supermileage/PROTO_PCB/PROTO_PCB-15_05_2023.png

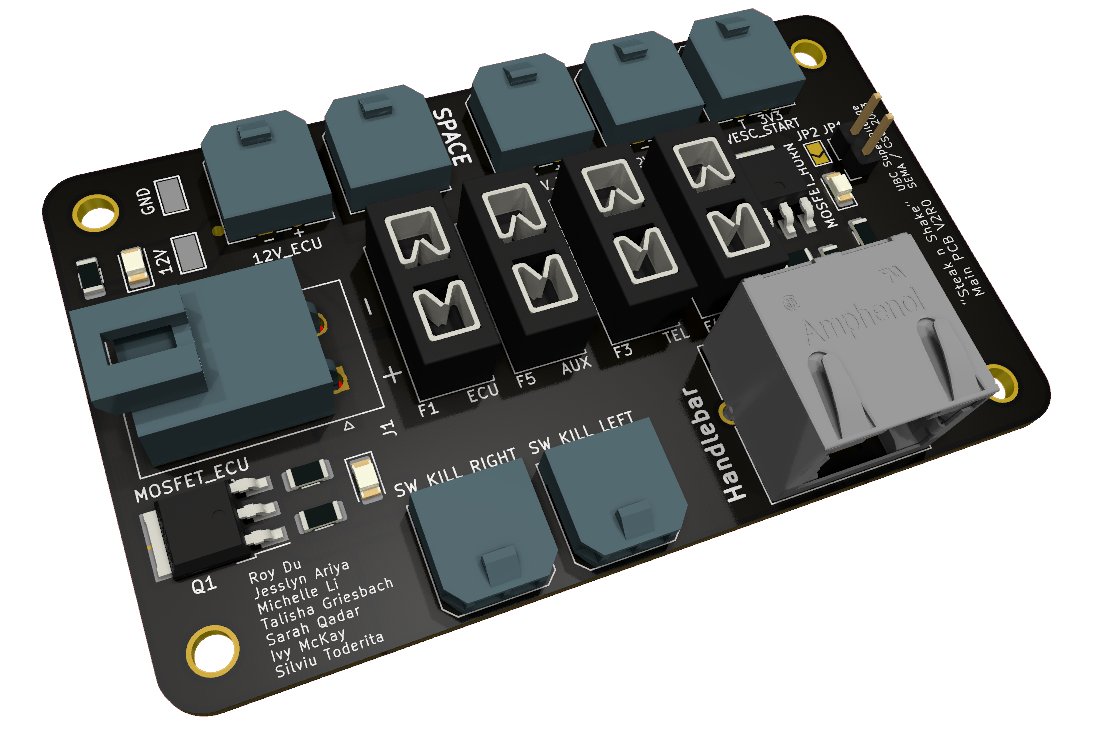
PROTO_PCB-15_05_2023.png
