supermileage/PROTO_PCB/BOM.xlsx

Designator | Qty | Manufacturer | Mfg Part # | Description / Value | DigiKey URL
F1,F2,F3,F4,F5 | 5 | Keystone Electronics | 3568 | FUSE HOLDER BLADE 500V 30A PCB | https://www.digikey.ca/en/products/detail/keystone-electronics/3568/2137306
J1 | 1 | Molex | 2002411212 | Connector Header Through Hole, Right Angle 2 position 0.224" (5.70mm) | https://www.digikey.ca/en/products/detail/molex/2002411212/10709048?s=N4IgTCBcDa4AxzAFgIwrOkBdAvkA
J2,J3,J4,J5,J6,J7,J8,J9,J10,J11,J12 | 11 | Molex | 0436500200 | Connector Header Through Hole, Right Angle 2 position 0.118" (3.00mm) | https://www.digikey.ca/en/products/detail/molex/0436500200/268989
L1,L3,L4 | 3 | Lite-On Inc. | LTST-C230KGKT | LED GREEN CLEAR CHIP SMD | https://www.digikey.ca/en/products/detail/lite-on-inc/LTST-C230KGKT/386855
L2 | 1 | Lite-On Inc. | LTST-C230KRKT | LED RED CLEAR CHIP SMD | https://www.digikey.ca/en/products/detail/lite-on-inc/LTST-C230KRKT/386857
Q1,Q2 | 2 | Infineon Technologies | IRFR120ZTRPBF | MOSFET N-CH 100V 8.7A DPAK | https://www.digikey.ca/en/products/detail/infineon-technologies/IRFR120ZTRPBF/1928290
R1,R2,R4 | 3 | Stackpole Electronics Inc | RMCF1206FT1K00 | RES 1K OHM 1% 1/4W 1206 | https://www.digikey.ca/en/products/detail/stackpole-electronics-inc/RMCF1206FT1K00/1759616
R3,R5 | 2 | Stackpole Electronics Inc | RMCF1206FT10K0 | RES 10K OHM 1% 1/4W 1206 | https://www.digikey.ca/en/products/detail/stackpole-electronics-inc/RMCF1206FT10K0/1759669
R6 | 1 | Stackpole Electronics Inc | RMCF1206FT100R | RES 100 OHM 1% 1/4W 1206 | https://www.digikey.ca/en/products/detail/stackpole-electronics-inc/RMCF1206FT100R/1759677
Not on PCB:
 | 1 | Molex | 2004561212 | MEGA-FIT RECEP HSG SR TOPL 2CKT | https://www.digikey.ca/en/products/detail/molex/2004561212/10709200
 | 2 | Molex | 0768230344 | MEGA-FIT FEMALE TML PRE-TIN 14/1 | https://www.digikey.ca/en/products/detail/molex/0768230344/10482725
 | 11 | Molex | 0436450200 | CONN RECEPT 2POS 3MM SINGLE ROW | https://www.digikey.ca/en/products/detail/molex/0436450200/268974
 | 22 | Molex | 0430300001 | CONN SOCKET 20-24AWG CRIMP TIN | https://www.digikey.ca/en/products/detail/molex/0430300001/467796
 | 4 |  |  | M3 x 6mm Screws
 | 4 | Littelfuse Inc. | 0297002.L | FUSE AUTO 2A 32VDC BLADE MINI | https://www.digikey.ca/en/products/detail/littelfuse-inc/0297002-L/3305643
 | 1 | Littelfuse Inc. | 0297005.WXNV | FUSE AUTO 5A 32VDC BLADE MINI | https://www.digikey.ca/en/products/detail/littelfuse-inc/0297005-WXNV/146583
