supermileage/PROTO_PCB/PROTO_PCB.kicad_pcb

## KiCad design PROTO_PCB.kicad_pcb (2023-05-17)

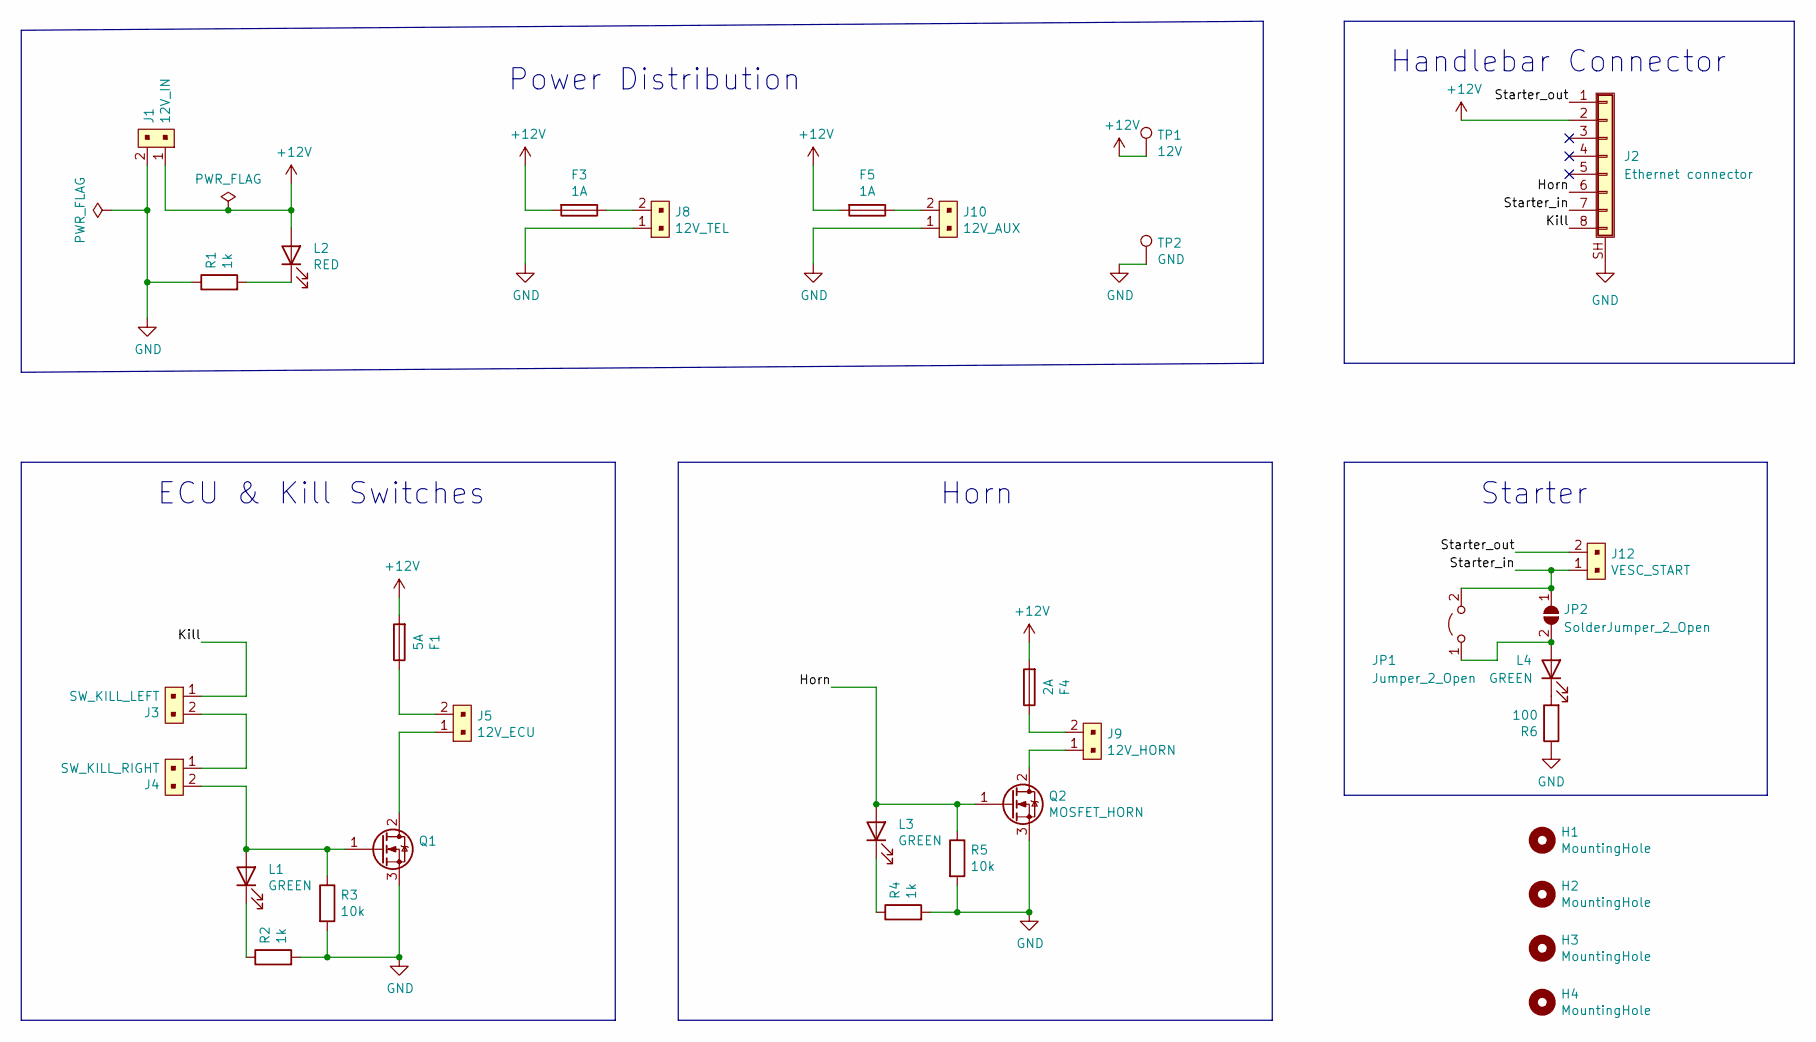
[picture p2: schematic PROTO_PCB.kicad_sch]

Parts:
F1: 5A; Fuseholder_Blade_Mini_Keystone_3568
F3, F5: 1A; Fuseholder_Blade_Mini_Keystone_3568
F4: 2A; Fuseholder_Blade_Mini_Keystone_3568
H1, H2, H3, H4: MountingHole; MountingHole_3.2mm_M3
J1: 12V_IN; MOLEX_2002411212
J2: Ethernet connector; RJ45_Amphenol_RJHSE5380
J3: SW_KILL_LEFT; Molex_Micro-Fit_3.0_43650-0200_1x02_P3.00mm_Horizontal
J4: SW_KILL_RIGHT; Molex_Micro-Fit_3.0_43650-0200_1x02_P3.00mm_Horizontal
J5: 12V_ECU; Molex_Micro-Fit_3.0_43650-0200_1x02_P3.00mm_Horizontal
J8: 12V_TEL; Molex_Micro-Fit_3.0_43650-0200_1x02_P3.00mm_Horizontal
J9: 12V_HORN; Molex_Micro-Fit_3.0_43650-0200_1x02_P3.00mm_Horizontal
J10: 12V_AUX; Molex_Micro-Fit_3.0_43650-0200_1x02_P3.00mm_Horizontal
J12: VESC_START; Molex_Micro-Fit_3.0_43650-0200_1x02_P3.00mm_Horizontal
JP1: Jumper_2_Open; PinSocket_1x02_P2.54mm_Vertical
JP2: SolderJumper_2_Open; SolderJumper-2_P1.3mm_Open_TrianglePad1.0x1.5mm
L1, L3, L4: GREEN; LED_1206_3216Metric
L2: RED; LED_1206_3216Metric
Q1: (no value)
Q2: MOSFET_HORN; TO-252-3_TabPin2
R1, R2, R4: 1k; R_1206_3216Metric
R3, R5: 10k; R_1206_3216Metric
R6: 100; R_1206_3216Metric
TP1: 12V; TestPoint_Keystone_5015_Micro-Minature
TP2: GND; TestPoint_Keystone_5015_Micro-Minature

Connections:
+12V: F1.2, F3.2, F4.2, F5.2, J1.1, J2.2, L2.2 (A), TP1.1
/Horn: J2.6, L3.2 (A), Q2.1 (G), R5.1
/Kill: J2.8, J3.1
/Starter_in: J2.7, J12.1, JP1.2 (B), JP2.1 (A)
/Starter_out: J2.1, J12.2
GND: J1.2, J2.SH (Shield), J8.1, J10.1, Q1.3 (S), Q2.3 (S), R1.1, R2.2, R3.2, R4.2, R5.2, R6.1, TP2.1
unnamed: F1.1, J5.2
unnamed: F3.1, J8.2
unnamed: F4.1, J9.2
unnamed: F5.1, J10.2
unnamed: J3.2, J4.1
unnamed: J4.2, L1.2 (A), Q1.1 (G), R3.1
unnamed: J5.1, Q1.2 (D)
unnamed: J9.1, Q2.2 (D)
unnamed: L1.1 (K), R2.1
unnamed: L2.1 (K), R1.2
unnamed: L3.1 (K), R4.1
unnamed: L4.1 (K), R6.2
unnamed: JP1.1 (A), JP2.2 (B), L4.2 (A)

Notes on the sheet:
Horn
Handlebar Connector
Starter
ECU & Kill Switches
Power Distribution

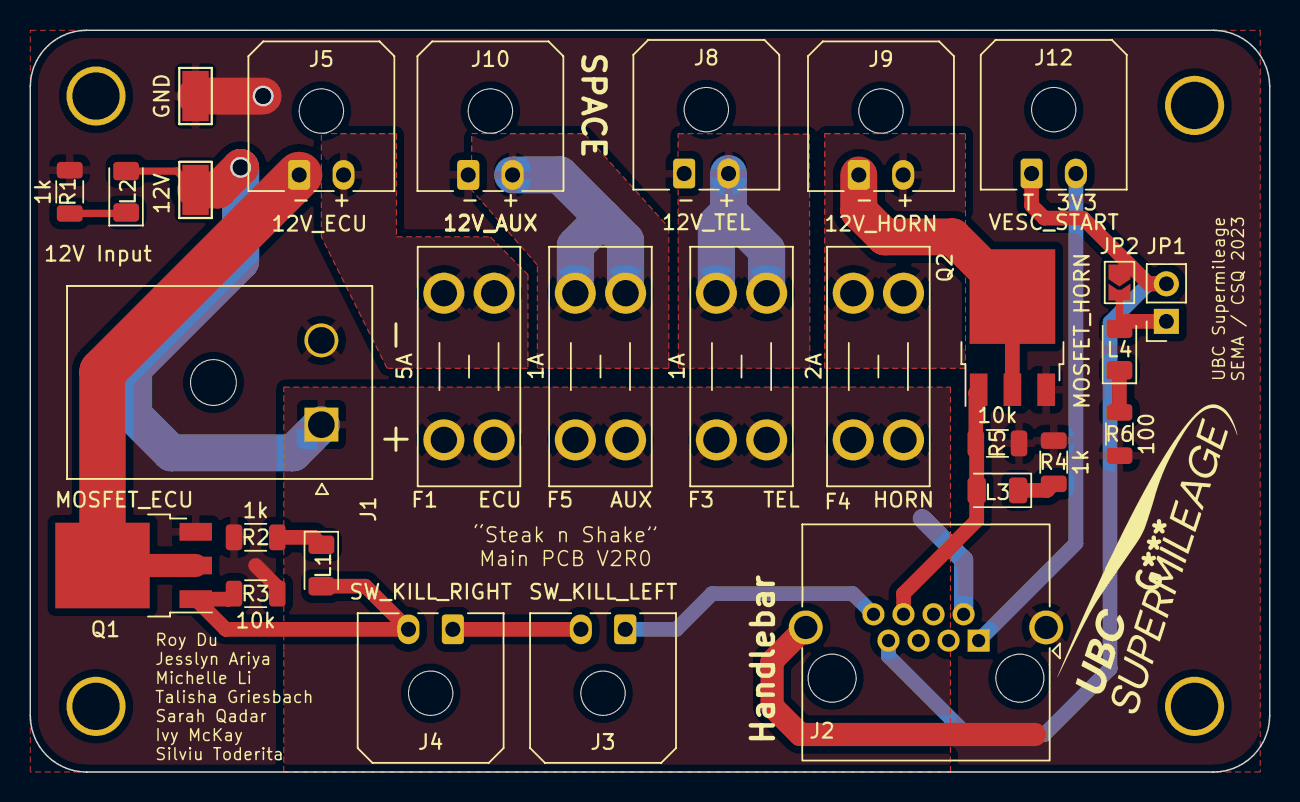
[picture p3: board PROTO_PCB.kicad_pcb from above]

Board: 2 copper layers, 83.8 x 50.2 mm, 33 parts (0 on the bottom side), 19 nets.
