supermileage/PROTO_PCB/(commit log)

2022-01-15 Uploading first draft
    [PROTO_PCB_2022.kicad_pcb, PROTO_PCB_2022.sch]
2022-01-16 Minor changes
    [PROTO_PCB_2022.sch]
2022-01-16 Added ECU molex
    [PROTO_PCB_2022.sch]
2022-01-18 Continued development
    [PROTO_PCB_2022.kicad_pcb, PROTO_PCB_2022.sch]
2022-01-18 Added footprints/PNs for connectors and updated resistors
    [PROTO_PCB_2022.sch]
2022-01-19 Review and fix power connectors
    [PROTO_PCB_2022.sch]
2022-01-20 Added O2 sensor connector
    [PROTO_PCB_2022.sch]
2022-01-22 Changed power connectors to terminal blocks, updated molex connectors
    [PROTO_PCB_2022.sch]
2022-01-22 Fixed connectors, removed MCU, final first draft
    [PROTO_PCB_2022.sch]
2022-01-22 Updated ECU connector
    [PROTO_PCB_2022.kicad_pcb, PROTO_PCB_2022.sch]
2022-01-30 replaced 4 pin ECU_EN with 3 2 pin connectors, removed ECU relay and set ECU kill switches in series
    [PROTO_PCB_2022.sch]
2022-03-14 added new TVS diodes to schematic
    [PROTO_PCB_2022.kicad_pcb, PROTO_PCB_2022.sch]
2022-03-26 board layout done
    [PROTO_PCB_2022.kicad_pcb, PROTO_PCB_2022.sch]
2022-04-21 layout completed: components arranged, traces created
    [PROTO_PCB_2022.kicad_pcb]
2022-04-22 Draft PCB for Report Purposes
    [PROTO_PCB_2022.kicad_pcb, PROTO_PCB_2022.sch]
2022-04-22 second version
    [PROTO_PCB_2022.kicad_pcb, PROTO_PCB_2022.sch]
2022-04-23 after design review edits start
    [PROTO_PCB_2022.sch]
2022-04-23 changed mosfet
    [PROTO_PCB_2022.sch]
2022-04-24 almost final version
    [PROTO_PCB_2022.kicad_pcb, PROTO_PCB_2022.sch]
2022-04-25 final design with gerbers
    [PROTO_PCB_2022-B_Cu.gbr, PROTO_PCB_2022-B_Mask.gbr, PROTO_PCB_2022-B_Paste.gbr, PROTO_PCB_2022-B_SilkS.gbr, PROTO_PCB_2022-Edge_Cuts.gbr, PROTO_PCB_2022-F_Cu.gbr, PROTO_PCB_2022-F_Mask.gbr, PROTO_PCB_2022-F_Paste.gbr]
2022-05-11 schematic done
    [PROTO_PCB_2022.kicad_pcb, PROTO_PCB_2022.sch]
2022-05-11 finished PCB layout
    [PROTO_PCB_2022.kicad_pcb, PROTO_PCB_2022.sch]
2022-05-12 did some more layout work
    [PROTO_PCB_2022.kicad_pcb, PROTO_PCB_2022.sch]
2022-05-12 even more layout changes
    [PROTO_PCB_2022.kicad_pcb, PROTO_PCB_2022.sch]
2022-05-13 finishes schematic, footprint assignment, and BOM
    [PROTO_PCB_2022.kicad_pcb, PROTO_PCB_2022.sch]
2022-05-13 changed starter LED resistor value from 1k to 100
    [PROTO_PCB_2022.sch]
2022-05-15 new layout
    [PROTO_PCB_2022.kicad_pcb, PROTO_PCB_2022.sch]
2022-05-15 updates silkscreen and minor tracing
    [PROTO_PCB_2022.kicad_pcb]
2022-05-15 added some more labels to layout and made BOM doc
    [BOM.xlsx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]
2022-05-16 final touch-ups
    [PROTO_PCB_2022-B_Cu.gbr, PROTO_PCB_2022-B_Mask.gbr, PROTO_PCB_2022-B_SilkS.gbr, PROTO_PCB_2022-Edge_Cuts.gbr, PROTO_PCB_2022-F_Cu.gbr, PROTO_PCB_2022-F_Mask.gbr, PROTO_PCB_2022-F_SilkS.gbr, PROTO_PCB_2022-job.gbrjob]
2023-05-14 Changes handlebar connector to RJ45
    [PROTO_PCB_2022.kicad_pcb, PROTO_PCB_2022.kicad_sch]
2023-05-14 Renames files remove year
    [PROTO_PCB.kicad_pcb, PROTO_PCB.kicad_sch, PROTO_PCB.sch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]
2023-05-14 VESC connector labels
    [PROTO_PCB.kicad_pcb, PROTO_PCB.kicad_sch]
2023-05-17 2023 pcb
    [PROTO_PCB-B_Cu.gbl, PROTO_PCB-B_Mask.gbs, PROTO_PCB-B_Paste.gbp, PROTO_PCB-B_Silkscreen.gbo, PROTO_PCB-Edge_Cuts.gm1, PROTO_PCB-F_Cu.gtl, PROTO_PCB-F_Mask.gts, PROTO_PCB-F_Paste.gtp]
